KaveeshwaraBandara/rocker-bogie-rover/docs/images/nav_costmap.png

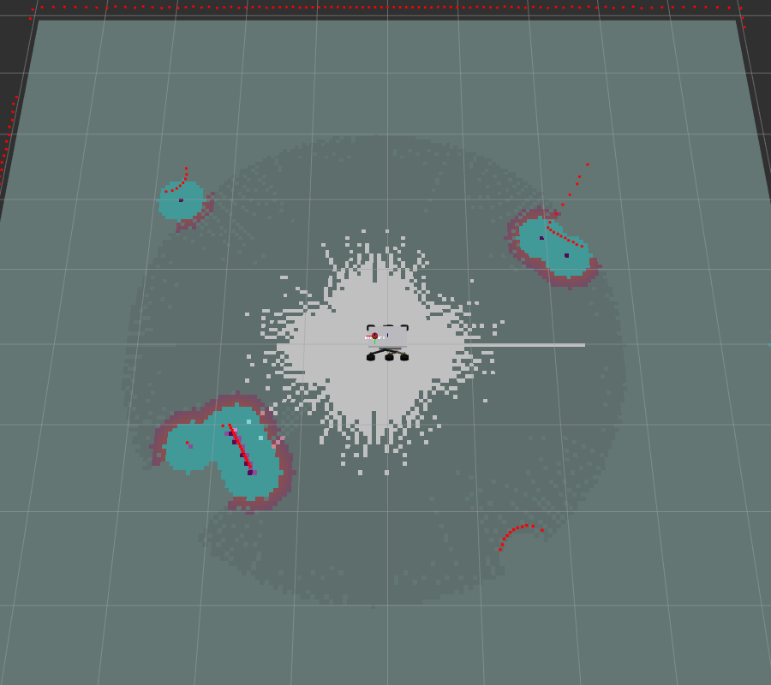
docs/images/nav_costmap.png
