KaveeshwaraBandara/rocker-bogie-rover/Ishara_Assembly/Tie rod assembl.SLDASM

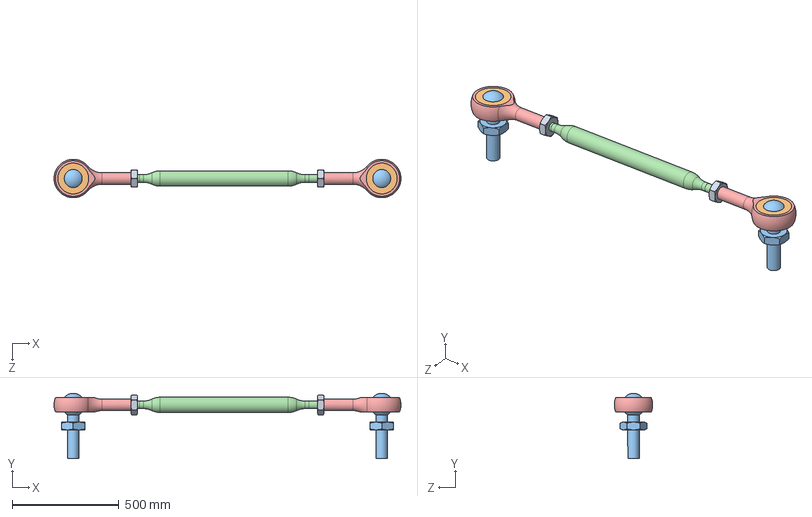
[picture p7: CAD file, 2026-07-17]
Ishara_Assembly/Tie rod assembl.SLDASM
1623.8 x 306.0 x 179.9 mm
Ishara_10 x 2
Ishara_11
Ishara_8 x 2
Ishara_9 x 2
Ishara_12 x 2
