KaveeshwaraBandara/rocker-bogie-rover/Ishara_Assembly/Assem7 - right.SLDASM

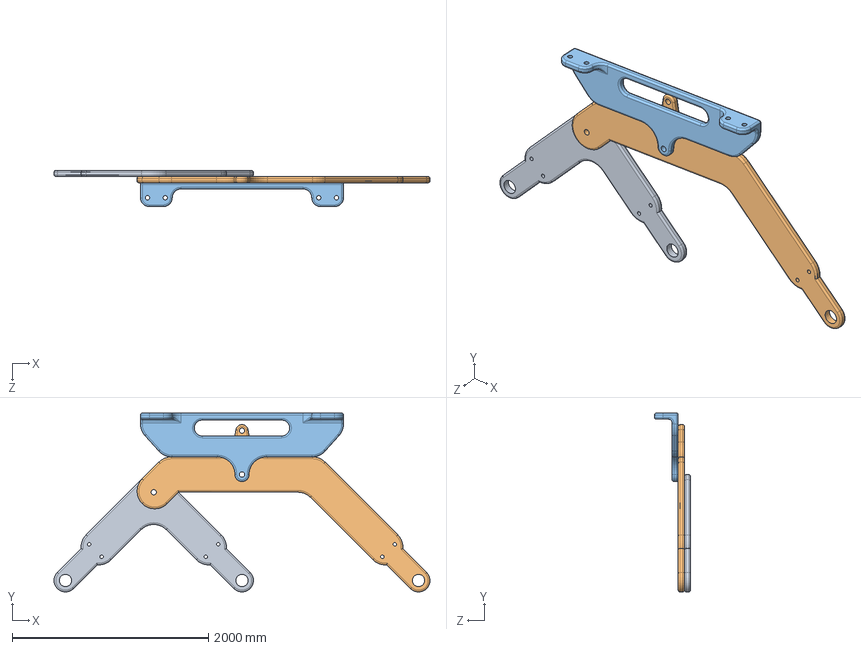
[picture p8: CAD file, 2026-07-17]
Ishara_Assembly/Assem7 - right.SLDASM
3834.0 x 1824.3 x 369.0 mm
Ishara_3
Ishara_1
Ishara_2
