KaveeshwaraBandara/rocker-bogie-rover/Ishara_Assembly/Ishara_Assembly.SLDASM

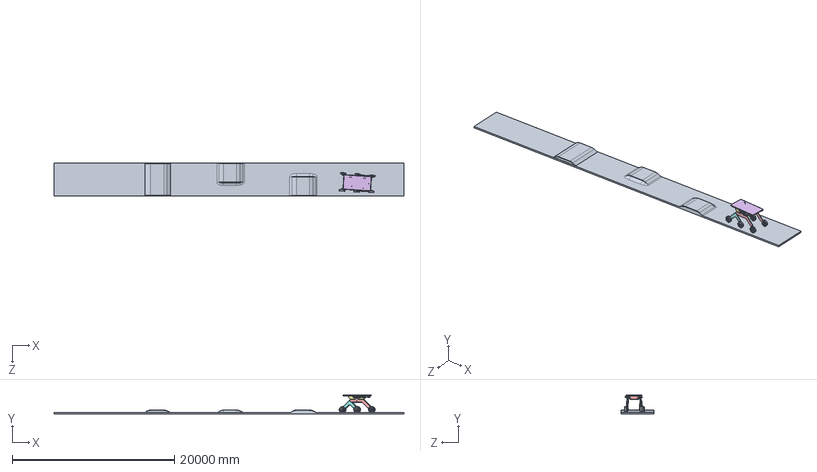
[picture p9: CAD file, 2026-07-17]
Ishara_Assembly/Ishara_Assembly.SLDASM
43200.0 x 2337.3 x 4050.0 mm
Ishara_1 x 2
Ishara_10 x 4
Ishara_11 x 2
Ishara_12 x 4
Ishara_13
Ishara_2 x 2
Ishara_3 x 2
Ishara_4
Ishara_5
Ishara_6
Ishara_8 x 4
Ishara_9 x 4
Wheel_ishara x 6
