KaveeshwaraBandara/rocker-bogie-rover/Ishara_Assembly/Ishara_11.SLDPRT

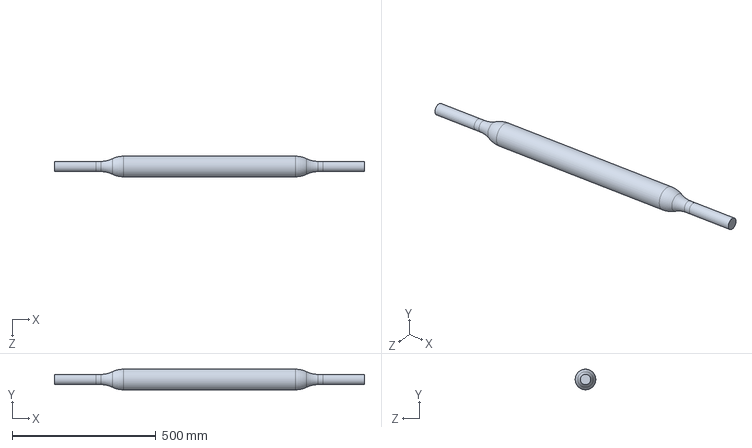
[picture p10: CAD file, 2026-07-17]
Ishara_Assembly/Ishara_11.SLDPRT
1080.0 x 72.0 x 72.0 mm
