KaveeshwaraBandara/rocker-bogie-rover/Ishara_Assembly/Ishara_8.SLDPRT

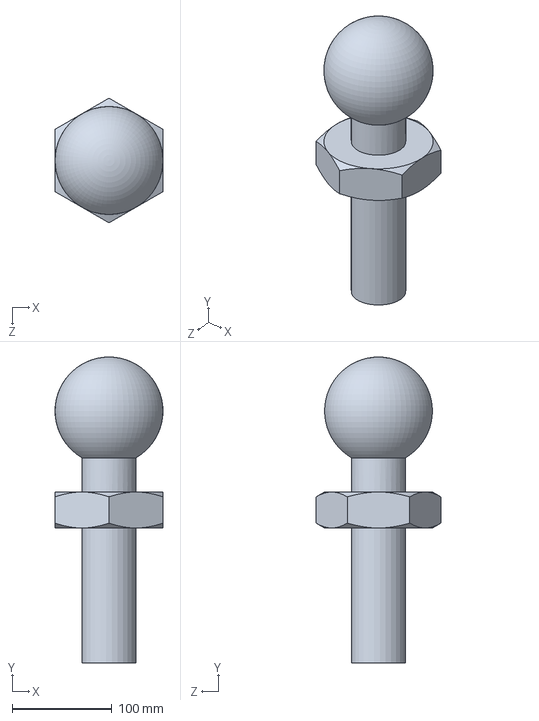
[picture p11: CAD file, 2026-07-17]
Ishara_Assembly/Ishara_8.SLDPRT
108.0 x 306.0 x 124.7 mm
