KaveeshwaraBandara/rocker-bogie-rover/Ishara_Assembly/Ishara_1.SLDPRT

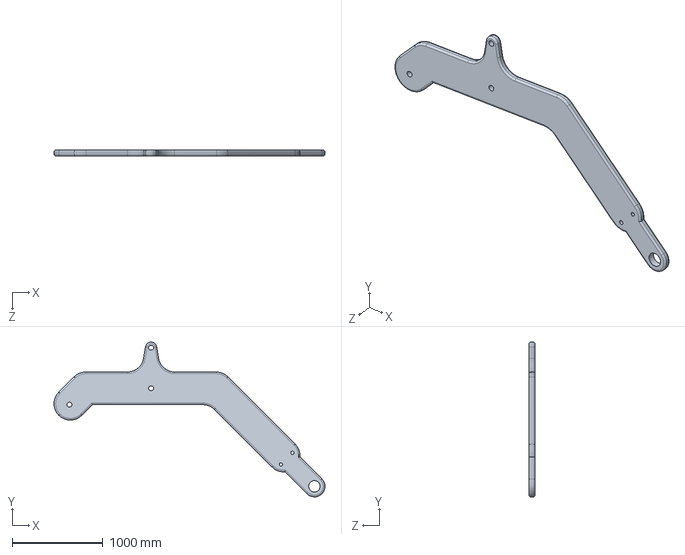
[picture p12: CAD file, 2026-07-17]
Ishara_Assembly/Ishara_1.SLDPRT
2987.0 x 1706.8 x 63.0 mm
