KaveeshwaraBandara/rocker-bogie-rover/Ishara_Assembly/Ishara_2.SLDPRT

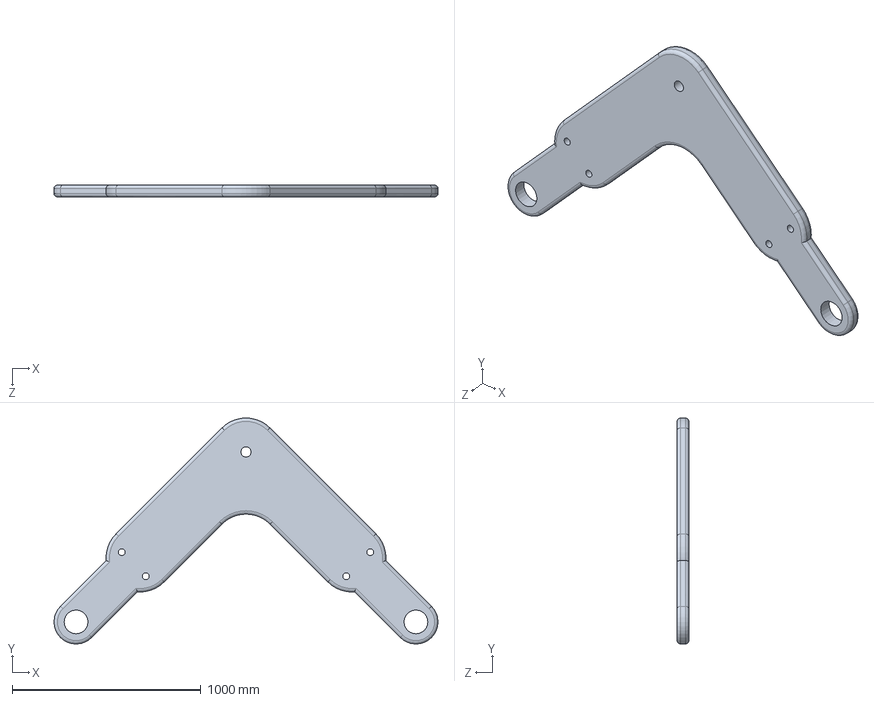
[picture p13: CAD file, 2026-07-17]
Ishara_Assembly/Ishara_2.SLDPRT
2034.0 x 1197.0 x 63.0 mm
