KaveeshwaraBandara/rocker-bogie-rover/Ishara_Assembly/Ishara_3.SLDPRT

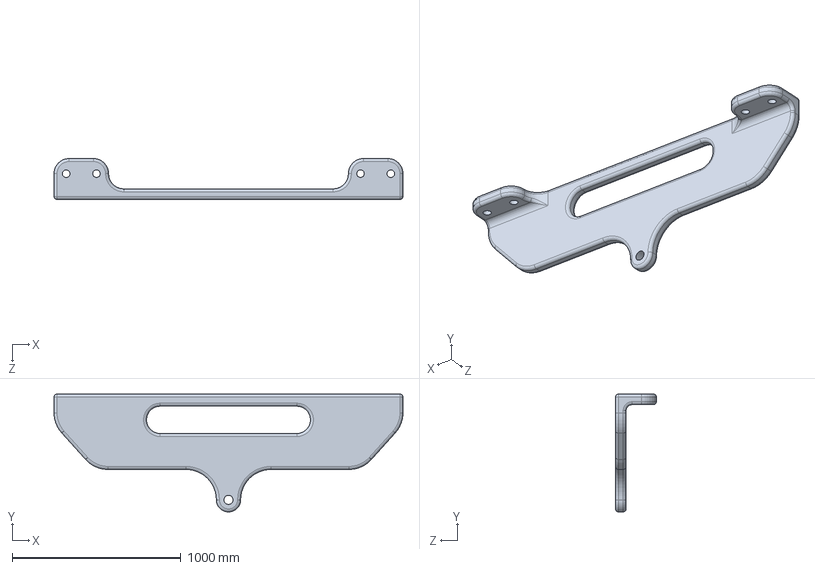
[picture p14: CAD file, 2026-07-17]
Ishara_Assembly/Ishara_3.SLDPRT
2070.0 x 699.3 x 243.0 mm
