KaveeshwaraBandara/rocker-bogie-rover/Ishara_Assembly/Ishara_6.SLDPRT

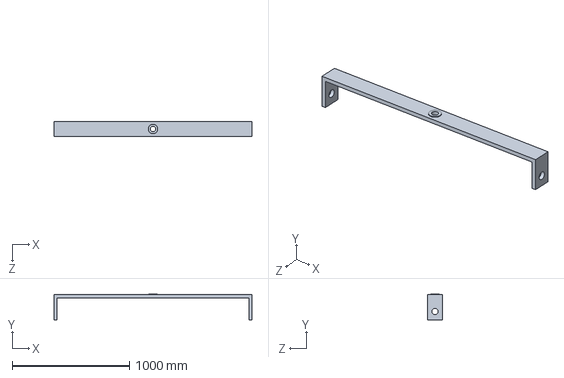
[picture p15: CAD file, 2026-07-17]
Ishara_Assembly/Ishara_6.SLDPRT
1692.0 x 220.5 x 126.0 mm
