KaveeshwaraBandara/rocker-bogie-rover/Ishara_Assembly/Ishara_4.SLDPRT

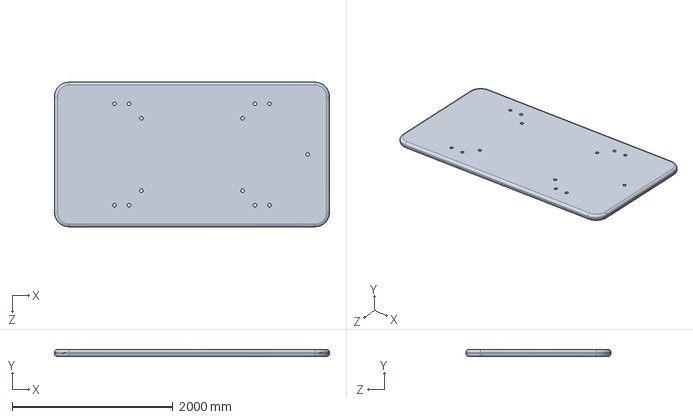
[picture p16: CAD file, 2026-07-17]
Ishara_Assembly/Ishara_4.SLDPRT
3420.0 x 90.0 x 1800.0 mm
