KaveeshwaraBandara/rocker-bogie-rover/Ishara_Assembly/Ishara_9.SLDPRT

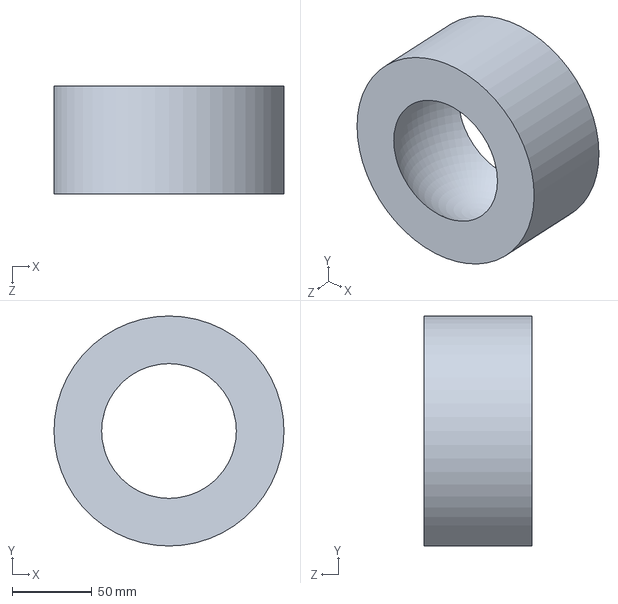
[picture p17: CAD file, 2026-07-17]
Ishara_Assembly/Ishara_9.SLDPRT
144.0 x 144.0 x 67.5 mm
