KaveeshwaraBandara/rocker-bogie-rover/Ishara_Assembly/Ishara_12.SLDPRT

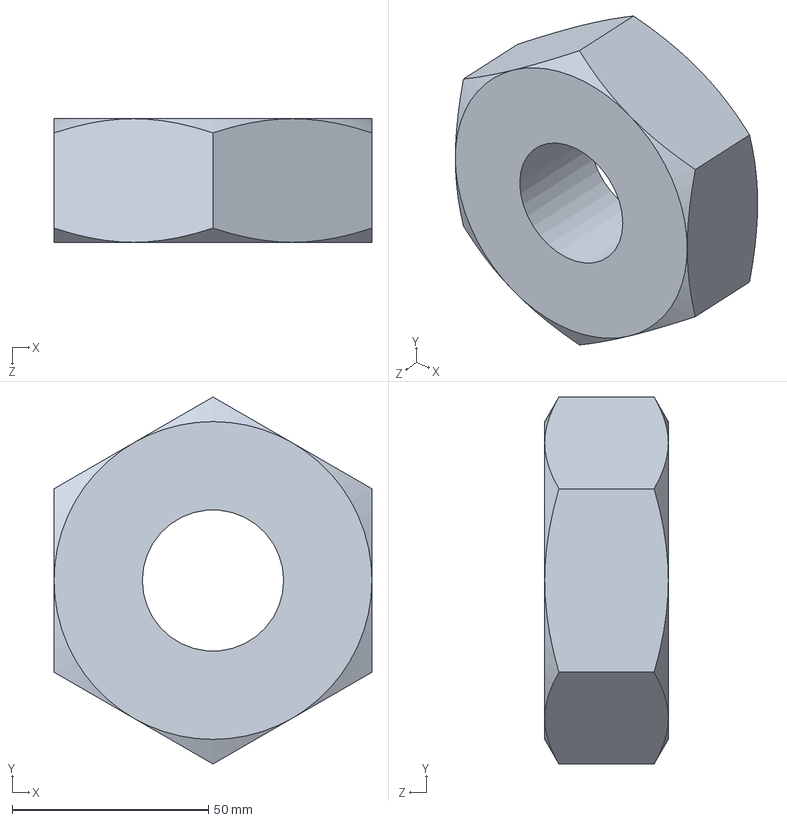
[picture p18: CAD file, 2026-07-17]
Ishara_Assembly/Ishara_12.SLDPRT
81.0 x 93.5 x 31.5 mm
