KaveeshwaraBandara/rocker-bogie-rover/Ishara_Assembly/Ishara_5.SLDPRT

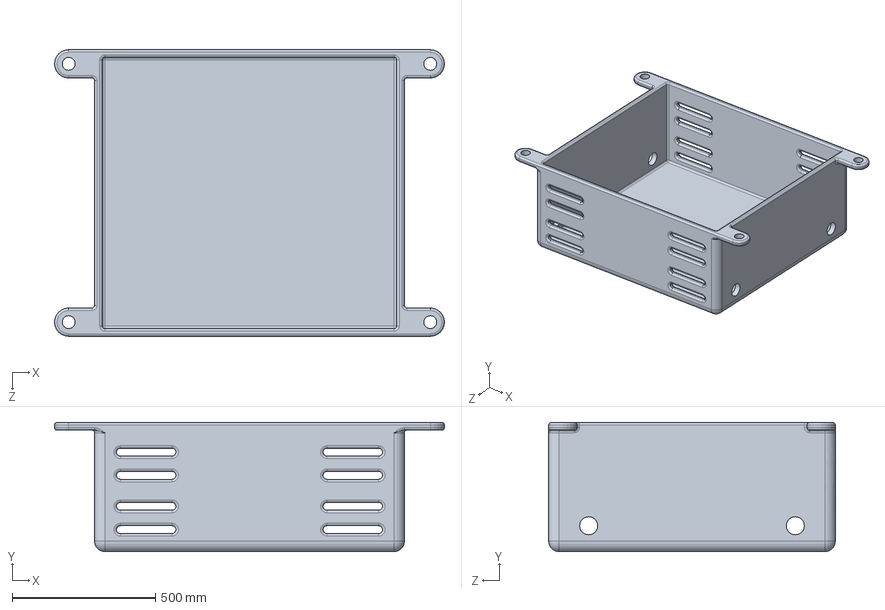
[picture p19: CAD file, 2026-07-17]
Ishara_Assembly/Ishara_5.SLDPRT
1359.0 x 450.0 x 999.0 mm
