KaveeshwaraBandara/rocker-bogie-rover/Ishara_Assembly/Ishara_10.SLDPRT

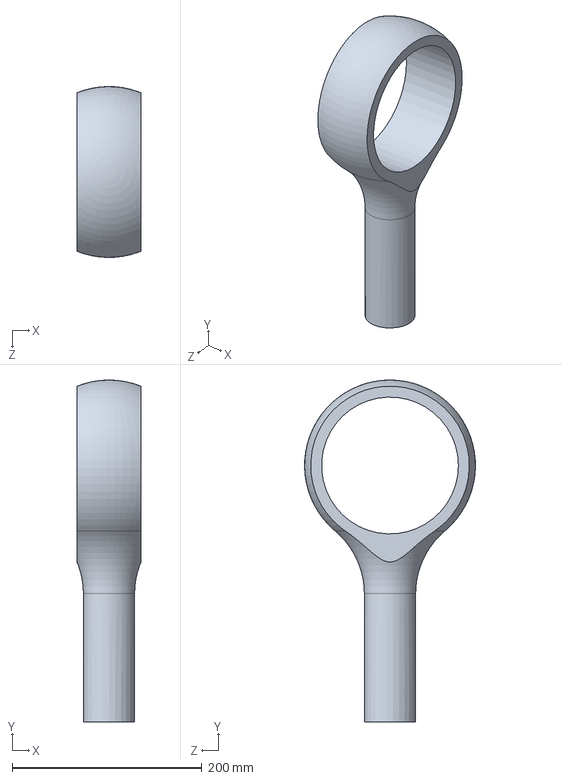
[picture p20: CAD file, 2026-07-17]
Ishara_Assembly/Ishara_10.SLDPRT
67.5 x 360.0 x 179.9 mm
