KaveeshwaraBandara/rocker-bogie-rover/Ishara_Assembly/Ishara_13.SLDPRT

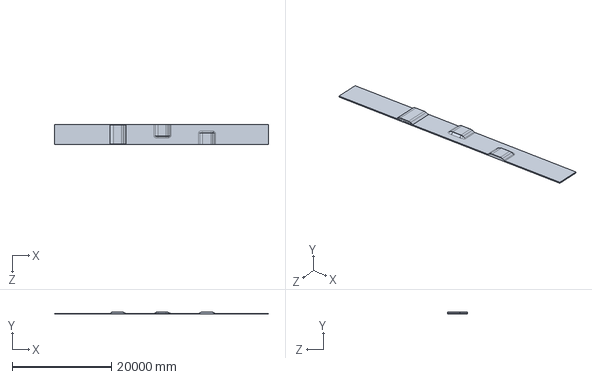
[picture p21: CAD file, 2026-07-17]
Ishara_Assembly/Ishara_13.SLDPRT
43200.0 x 486.0 x 4050.0 mm
