KaveeshwaraBandara/rocker-bogie-rover/Ishara_Assembly/Wheel_ishara.SLDPRT

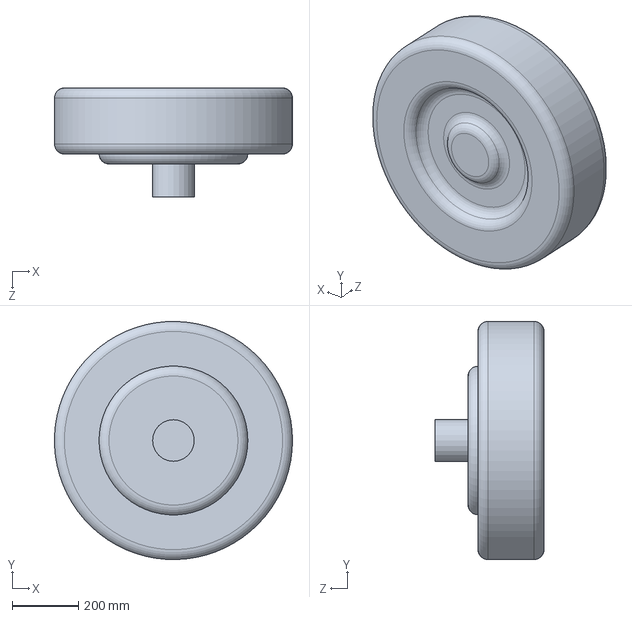
[picture p22: CAD file, 2026-07-17]
Ishara_Assembly/Wheel_ishara.SLDPRT
719.7 x 719.8 x 330.0 mm
