KaveeshwaraBandara/rocker-bogie-rover/Ishara_Assembly/fastners - Ishara/Assem8.SLDASM

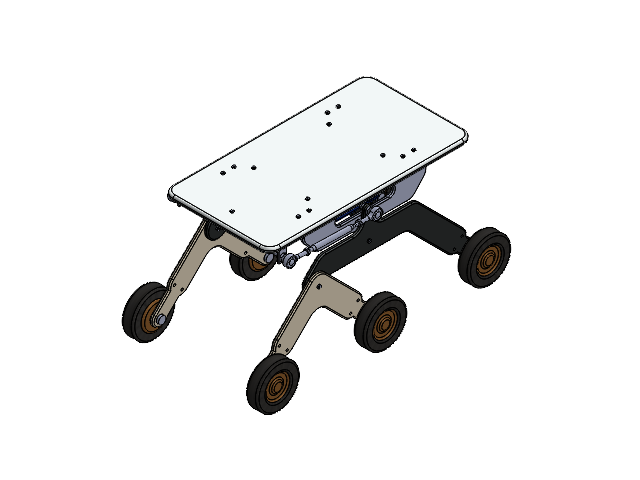
[picture p24: CAD file, 2026-07-17]
Ishara_Assembly/fastners - Ishara/Assem8.SLDASM
Ishara_6
Ishara_4
Ishara_5
Ishara - 2.5mm screw x 13
Ishara - 2.5mm nut x 13
Ishara_3 x 2
Ishara_1 x 2
Ishara_2 x 2
Ishara - 3mm screw x 4
Ishara - 3mm nut x 4
Ishara_10 x 4
Ishara_11 x 2
Ishara_8 x 4
Ishara_9 x 4
Ishara_12 x 8
Wheel_ishara x 6
