KaveeshwaraBandara/rocker-bogie-rover/Ishara_Assembly/platform assembl.SLDASM

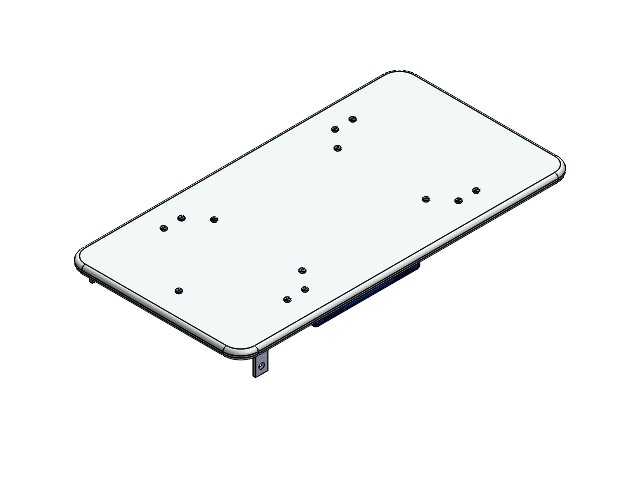
[picture p25: CAD file, 2026-07-17]
Ishara_Assembly/platform assembl.SLDASM
Ishara_6
Ishara_4
Ishara_5
Ishara - 2.5mm screw x 13
Ishara - 2.5mm nut x 13
