KaveeshwaraBandara/rocker-bogie-rover/(list of files, cad)

Other CAD files:
Ishara_Assembly/Assem6 -left.SLDASM
Ishara_Assembly/fastners - Ishara/2.5 mm screw and nut.SLDASM
Ishara_Assembly/fastners - Ishara/2mm screw and nut.SLDASM
Ishara_Assembly/fastners - Ishara/3mm screw and nut.SLDASM
Ishara_Assembly/fastners - Ishara/Ishara - 2.5mm nut.SLDPRT
Ishara_Assembly/fastners - Ishara/Ishara - 2.5mm screw.SLDPRT
Ishara_Assembly/fastners - Ishara/Ishara - 2mm nut.SLDPRT
Ishara_Assembly/fastners - Ishara/Ishara - 2mm screw.SLDPRT
Ishara_Assembly/fastners - Ishara/Ishara - 3mm nut.SLDPRT
Ishara_Assembly/fastners - Ishara/Ishara - 3mm screw.SLDPRT
