KaveeshwaraBandara/rocker-bogie-rover/Ishara_Assembly/screenshot/Screenshot 2026-07-16 221639.png

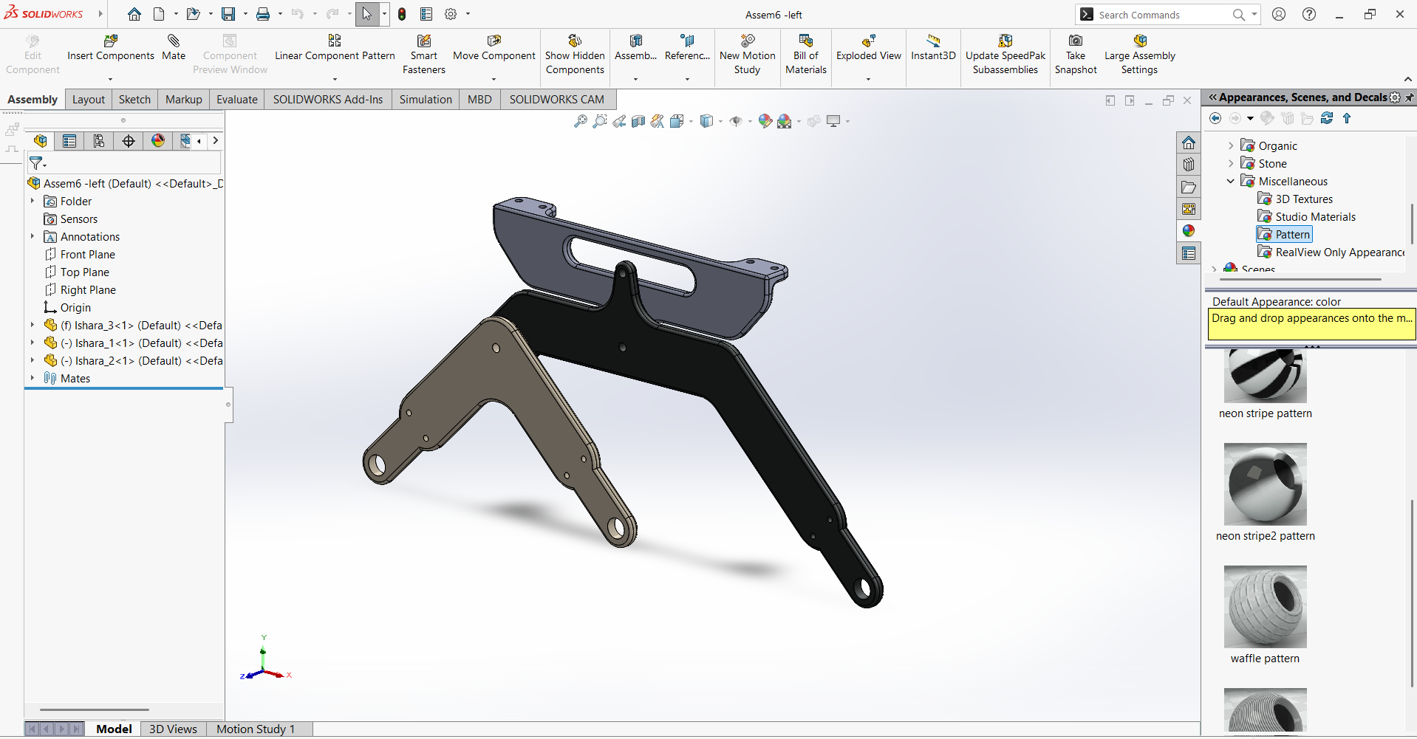
Ishara_Assembly/screenshot/Screenshot 2026-07-16 221639.png
