KaveeshwaraBandara/rocker-bogie-rover/Ishara_Assembly/screenshot/Screenshot 2026-07-16 221657.png

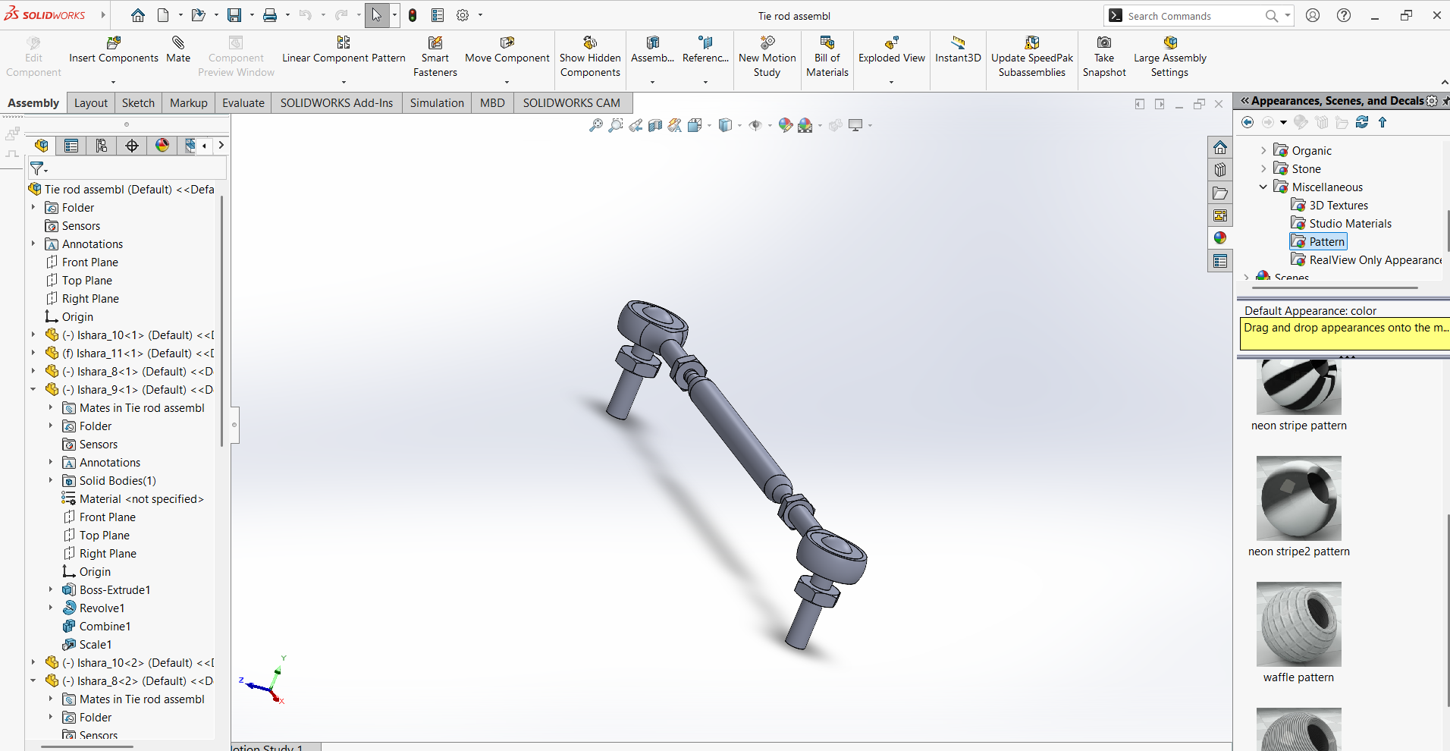
Ishara_Assembly/screenshot/Screenshot 2026-07-16 221657.png
