KaveeshwaraBandara/rocker-bogie-rover/(commit log)

2026-07-17 Add rocker-bogie rover ROS 2 workspace with RViz and Gazebo simulation
    [2.5 mm screw and nut.SLDASM, 2mm screw and nut.SLDASM, 3mm screw and nut.SLDASM, Assem6 -left.SLDASM, Assem7 - right.SLDASM, Assem8- final.SLDASM, Assem8.SLDASM, Ishara - 2.5mm nut.SLDPRT]
2026-07-17 Add SLAM mapping with slam_toolbox and calibrated skid-steer odometry
    [rover.gazebo.xacro]
2026-07-17 Add Mars demo world with boulder field, crater, canyon and ramps
    [mars_world.sdf]
2026-07-17 Add articulated rocker-bogie suspension demo with rough Mars terrain world
    [mars_rough_world.sdf, rover.gazebo.xacro, rover.urdf.xacro]
2026-07-17 Add mars_demo_world: autonomous SLAM+Nav2 with live bogie suspension
    New bogies_free suspension mode frees the independent bogie joints under
    DART (calibrated odometry intact) since bullet cannot skid-steer; demo
    world combines tall lidar obstacles with 260 climbable pebbles and logs.
    Verified: 4-goal autonomous tour all SUCCEEDED with bogies articulating.
    [mars_demo_world.sdf, rover.urdf.xacro]
2026-07-21 Fix front/back orientation, simulate differential via gz plugin, stop wheel liftoff
    [mars_rough_world.sdf, rover.gazebo.xacro, rover.urdf.xacro]
